bweq8527/GearPower/README.md

# GearPower

## 1.大致想法

灵感来自2024.09.02凌晨的一场梦，梦见一个超级炫酷的机甲，醒后依稀记得它的插入式电池仓，大致记录如下：
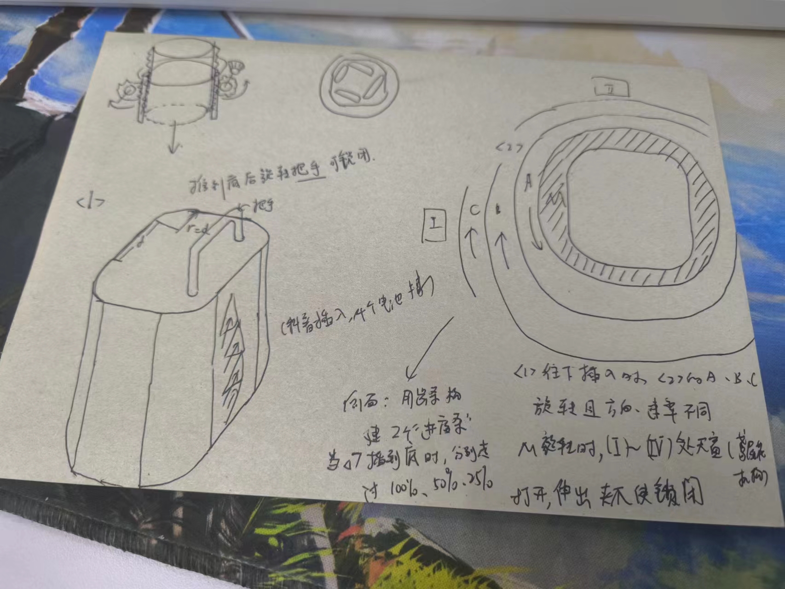
[picture p1: 0_Pics/0.jpg]


## 2.实现进度

①完成电池仓本体的设计及制造，效果如下：

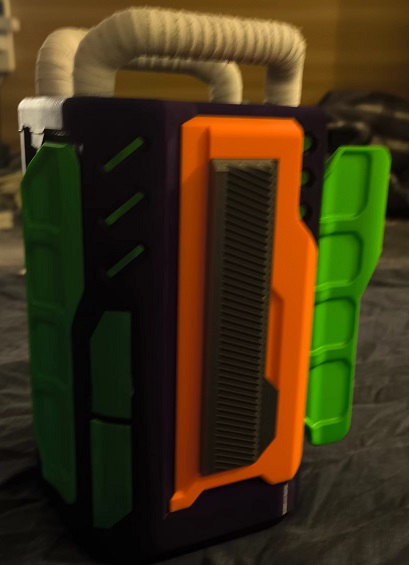
[picture p2: 0_Pics/1.jpg]


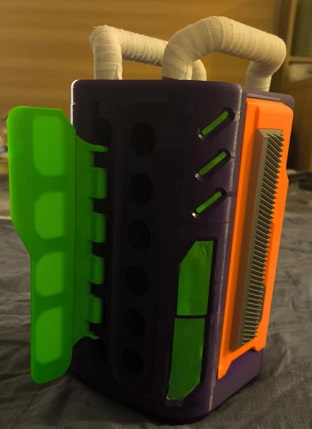
[picture p3: 0_Pics/2.jpg]


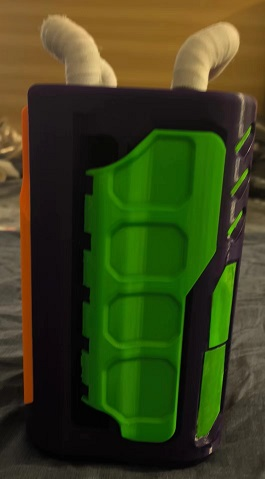
[picture p4: 0_Pics/3.jpg]


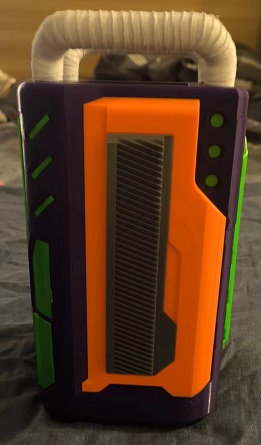
[picture p5: 0_Pics/4.jpg]


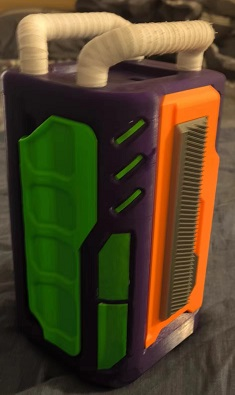
[picture p6: 0_Pics/5.jpg]


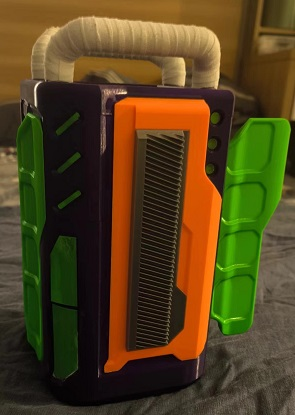
[picture p7: 0_Pics/6.jpg]


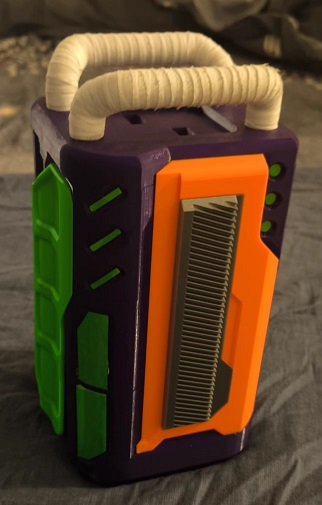
[picture p8: 0_Pics/7.jpg]
