bweq8527/GearPower/1_MechDesign/README.md

# BOM编制方式说明

#### 为方便查看各零件层级关系，辨别相似零件，采用如下编码原则：

1.A表示装配体，S表示零件

2.装配体结构层次序号按自顶向下递增的形式

3.ID为某零部件在项目中的唯一辨识序列号

#### 每个零部件的命名规则如下：

`A##`.`###`-`RK#`-`A/S` _ _ `[ID###]` _ _ `#####...`

> 第一段表示该零部件的父级是编号为##的子装配体

> 第二段表示该零部件在其所属的子装配体中的编号

> 第三段表示该零部件所属子装配体的层级

> 第四段表示该零部件类型，S为零件，A为装配体

> 第五段表示该零部件的唯一辨识序列号

> 第六段为零部件名称

注：上文命名规则中的空格作用为明确下划线个数，实际编码时，零件名称不存在空格

根据以上规则，当一个部件既是某个子装配体的顶层，又属于另一个装配体时，从两个不同的角度看，它会有不同的层级。因此生成两个同ID但不同编号的装配体来表示层级关系，如 `A02.000-RK4-S__[ID002]__BODY` 和 `A01.001.RK3-A__[ID002]__BODY` 是同一个装配体，由ID唯一确定。
