bweq8527/GearPower/1_MechDesign/A01.001-RK3-A__[ID012]__BODY.SLDASM

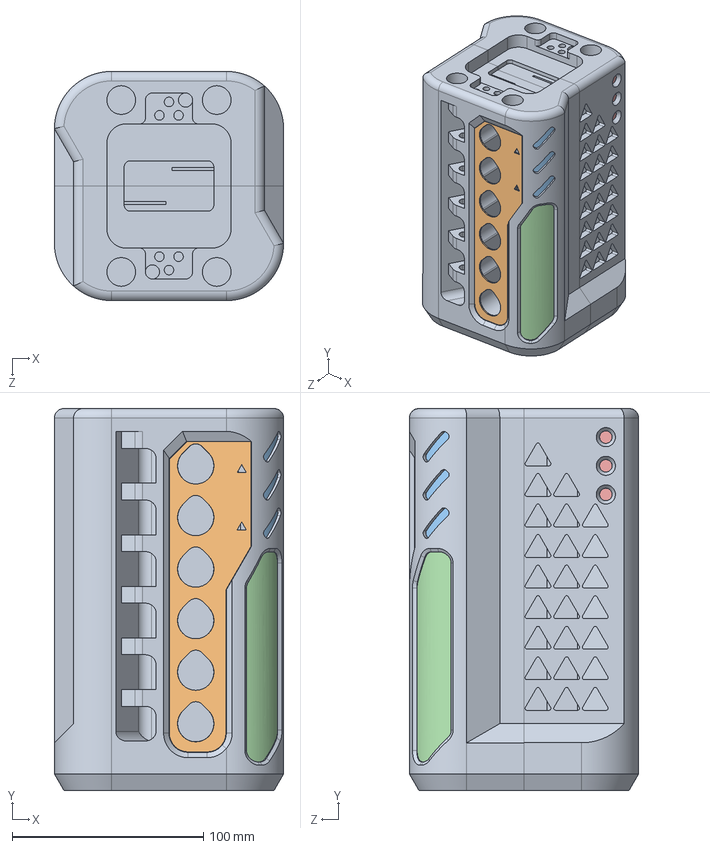
[picture p37: CAD file, 2024-11-07]
1_MechDesign/A01.001-RK3-A__[ID012]__BODY.SLDASM
120.0 x 200.0 x 120.0 mm
A02.001-RK4-S__[ID002]__Body
A02.002-RK4-S__[ID008]__Decoration1 x 2
A02.004-RK4-S__[ID010]__Decoration3 x 6
A02.003-RK4-S__[ID009]__Decoration2 x 2
A02.005-RK4-S__[ID011]__Decoration4 x 6
