bweq8527/GearPower/1_MechDesign/Locker.SLDASM

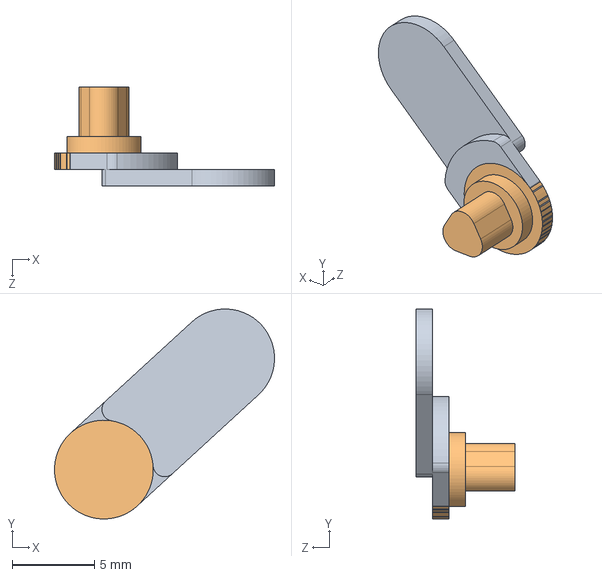
[picture p38: CAD file, 2024-11-07]
1_MechDesign/Locker.SLDASM
13.4 x 12.8 x 6.00 mm
Arm
Axis
