bweq8527/GearPower/1_MechDesign/A01.000-RK2-A__[ID001]__BatteryCompartment.SLDASM

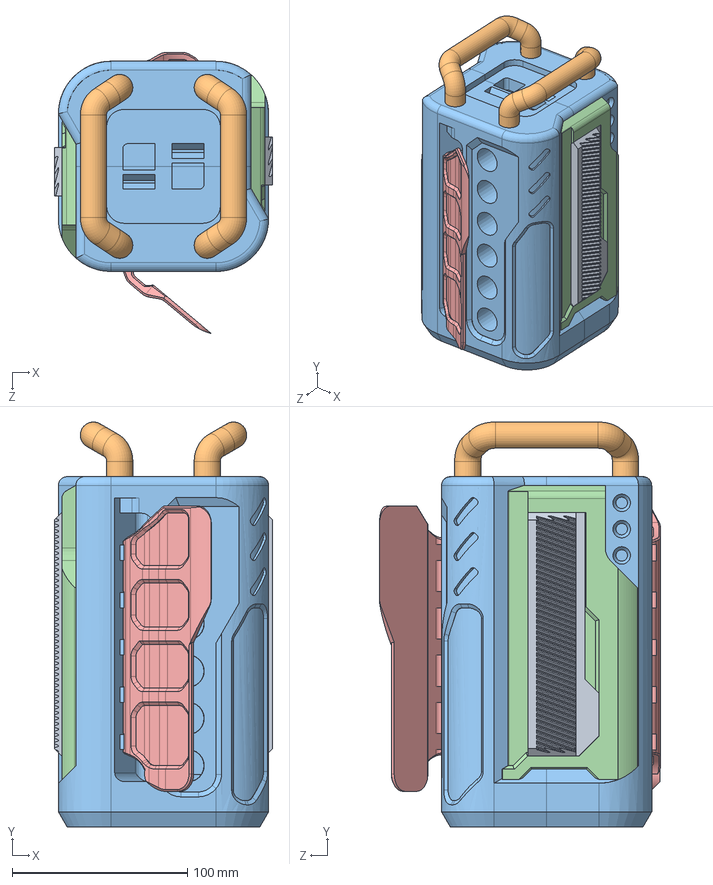
[picture p40: CAD file, 2024-10-26]
1_MechDesign/A01.000-RK2-A__[ID001]__BatteryCompartment.SLDASM
124.5 x 231.1 x 160.4 mm
A01.001-RK3-S__[ID002]__Body
A01.005-RK3-S__[ID006]__Handle x 2
A01.003-RK3-S__[ID004]__Connector1 x 2
A01.002-RK3-S__[ID003]__BatGov x 2
A01.004-RK3-S__[ID005]__GearRack1 x 2
