bweq8527/GearPower/2_Model/Body.STEP

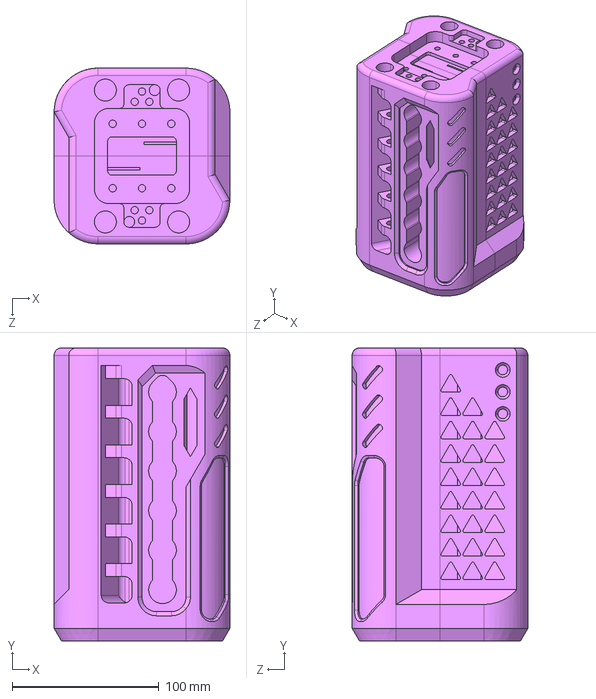
[picture p41: CAD file, 2024-11-07]
2_Model/Body.STEP
120.0 x 200.0 x 120.0 mm
