bweq8527/GearPower/2_Model/Model4-0.4.3mf

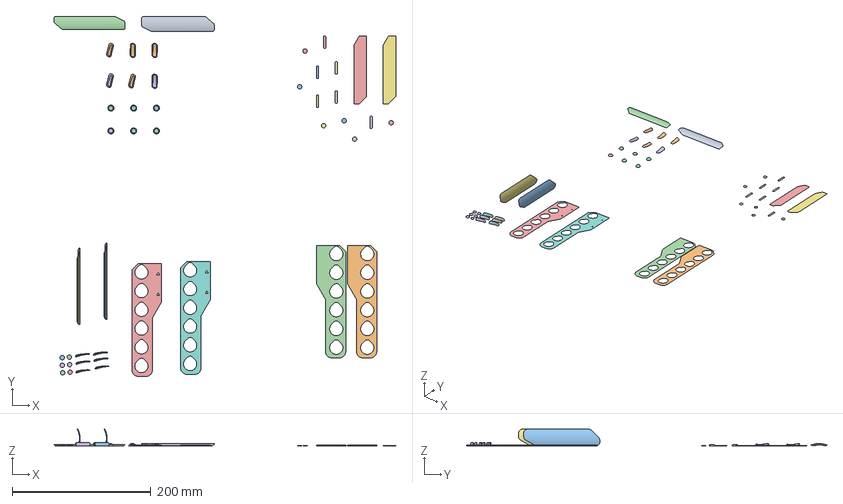
[picture p42: CAD file, 2024-11-07]
2_Model/Model4-0.4.3mf
492.5 x 519.1 x 24.1 mm
A01.001-RK3-S__[ID002.1]__Body-ex.STEP_8
Decoration1.STEP x 4
Decoration2.STEP x 2
Decoration3.STEP x 6
01245.STEP_1 x 3
A01.001-RK3-S__[ID002.1]__Body-ex.STEP_10
Decoration4.STEP x 6
01245.STEP_2
A01.001-RK3-S__[ID002.1]__Body-ex.STEP_20
01245.STEP_7
A01.001-RK3-S__[ID002.1]__Body-ex.STEP_11
01245.STEP_3
A01.001-RK3-S__[ID002.1]__Body-ex.STEP_9
01245.STEP_4 x 2
A01.001-RK3-S__[ID002.1]__Body-ex.STEP_12
01245.STEP_5
A01.001-RK3-S__[ID002.1]__Body-ex.STEP_21
01245.STEP_6 x 2
A01.001-RK3-S__[ID002.1]__Body-ex.STEP_14
01245.STEP_8
A01.001-RK3-S__[ID002.1]__Body-ex.STEP_22
A01.001-RK3-S__[ID002.1]__Body-ex.STEP_13
01245.STEP_10
A01.001-RK3-S__[ID002.1]__Body-ex.STEP_23
A01.001-RK3-S__[ID002.1]__Body-ex.STEP_15
01245.STEP_12
A01.001-RK3-S__[ID002.1]__Body-ex.STEP_24
A01.001-RK3-S__[ID002.1]__Body-ex.STEP_25
