bweq8527/GearPower/1_MechDesign/Arm.SLDPRT

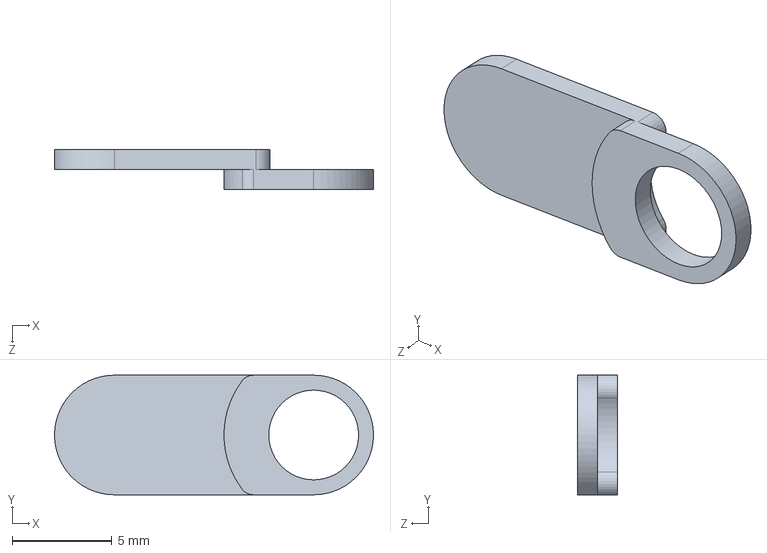
[picture p43: CAD file, 2024-11-07]
1_MechDesign/Arm.SLDPRT
16.0 x 6.00 x 2.00 mm
