bweq8527/GearPower/2_Model/Decoration1.STEP

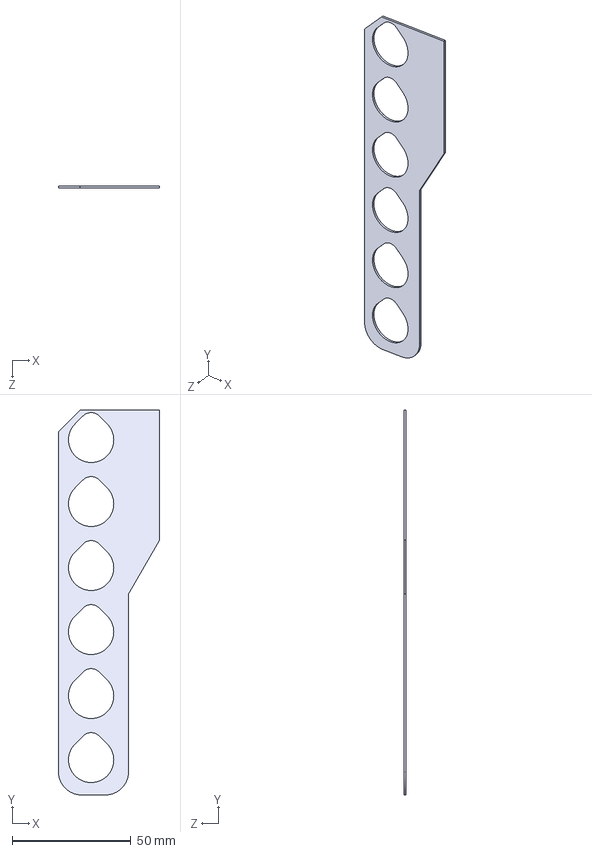
[picture p44: CAD file, 2024-11-07]
2_Model/Decoration1.STEP
42.7 x 162.4 x 1.00 mm
