bweq8527/GearPower/1_MechDesign/Axis.SLDPRT

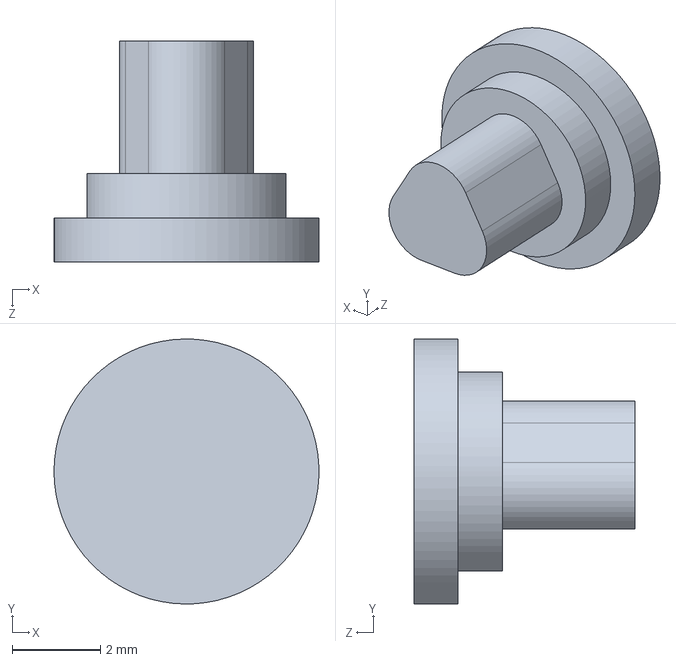
[picture p45: CAD file, 2024-11-07]
1_MechDesign/Axis.SLDPRT
6.00 x 6.00 x 5.00 mm
