bweq8527/GearPower/2_Model/Decoration2.STEP

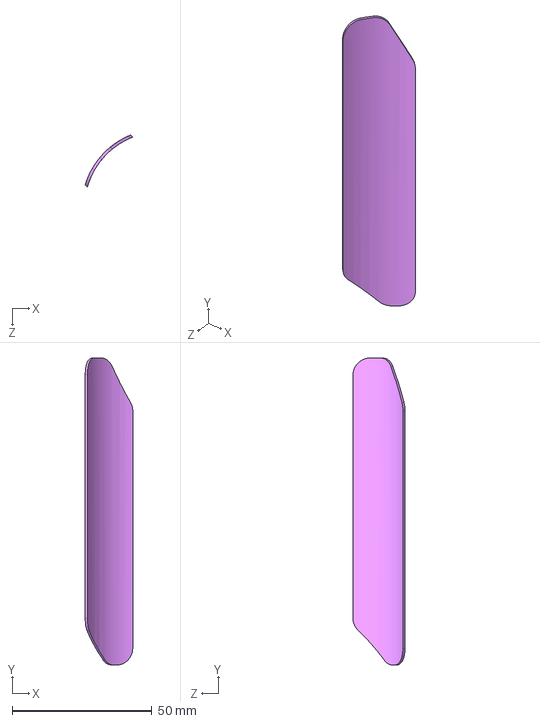
[picture p46: CAD file, 2024-11-07]
2_Model/Decoration2.STEP
17.1 x 110.0 x 18.6 mm
