bweq8527/GearPower/2_Model/Decoration3.STEP

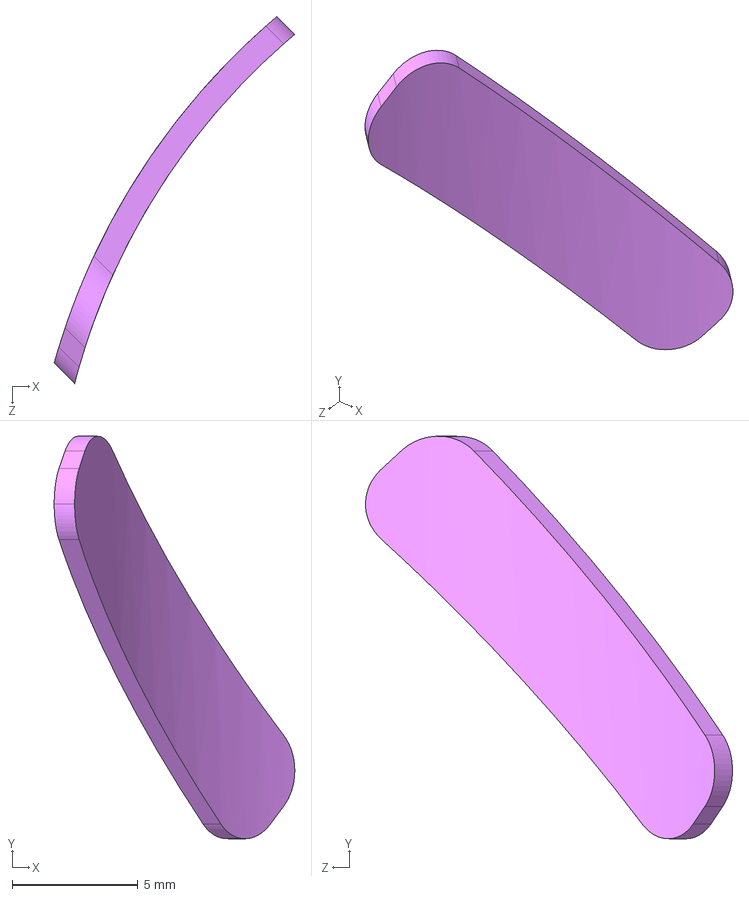
[picture p47: CAD file, 2024-11-07]
2_Model/Decoration3.STEP
9.58 x 16.0 x 14.6 mm
