bweq8527/GearPower/2_Model/Decoration4.STEP

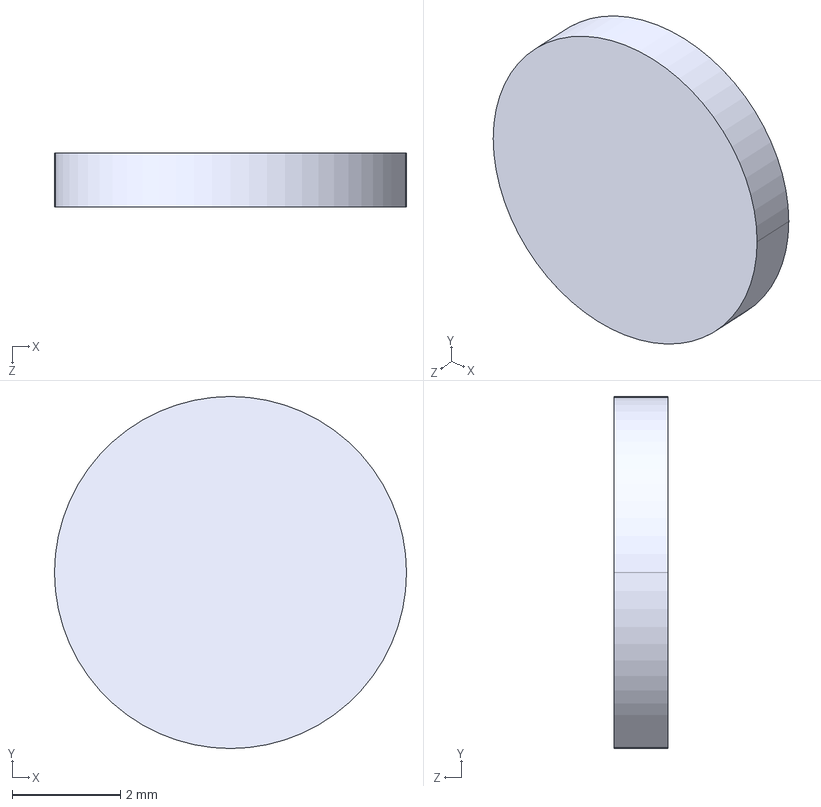
[picture p48: CAD file, 2024-11-07]
2_Model/Decoration4.STEP
6.50 x 6.50 x 1.00 mm
