bweq8527/GearPower/2_Model/Model2-0.4.3mf

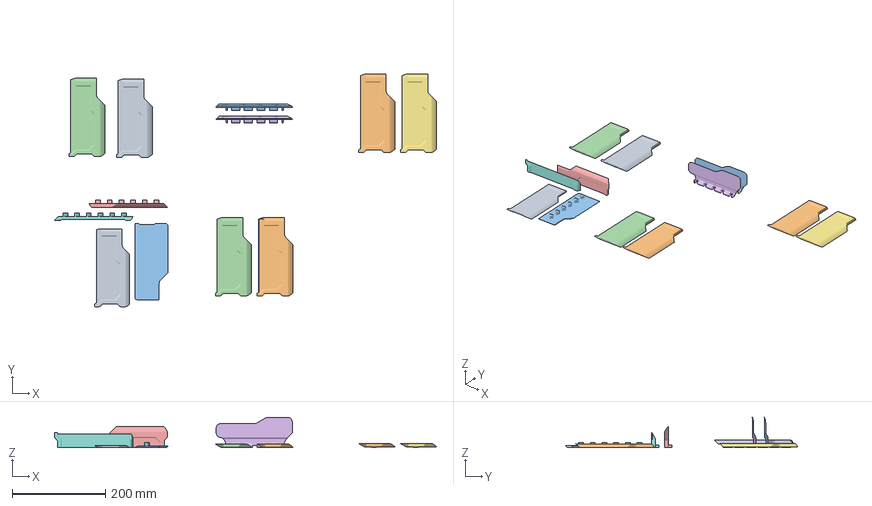
[picture p49: CAD file, 2024-10-31]
2_Model/Model2-0.4.3mf
817.9 x 498.0 x 64.8 mm
A01.003-RK3-S__[ID004]__Connector1.STEP x 4
A01.002-RK3-S__[ID003]__BatGov.STEP x 2
A01.003-RK3-S__[ID004]__Connector1.STEP_B x 2
A01.003-RK3-S__[ID004]__Connector1.STEP_A x 4
