bweq8527/GearPower/2_Model/Handle.STEP

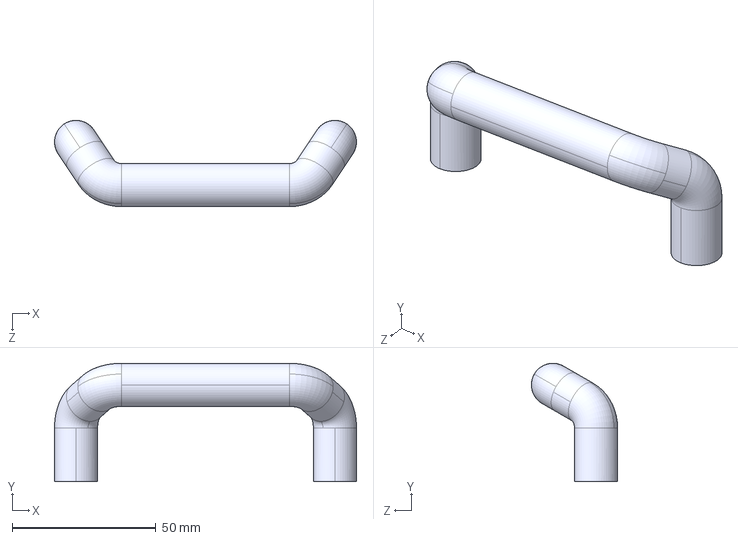
[picture p50: CAD file, 2024-10-29]
2_Model/Handle.STEP
105.0 x 41.2 x 30.0 mm
