bweq8527/GearPower/2_Model/BatGov.STEP

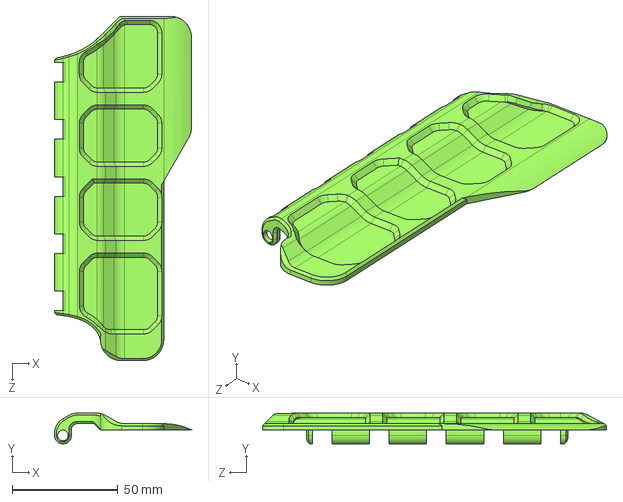
[picture p51: CAD file, 2024-10-29]
2_Model/BatGov.STEP
64.8 x 14.6 x 162.8 mm
