bweq8527/GearPower/2_Model/Model3-0.4.3mf

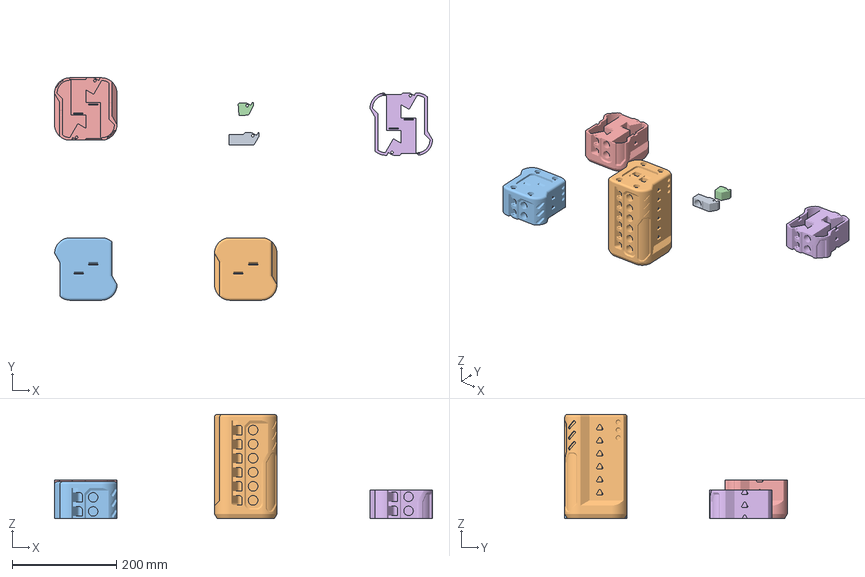
[picture p52: CAD file, 2024-10-29]
2_Model/Model3-0.4.3mf
725.7 x 427.2 x 200.0 mm
A01.001-RK3-S__[ID002]__Body.STEP_A_B_A_B_B_A
A01.001-RK3-S__[ID002]__Body.STEP
A01.001-RK3-S__[ID002]__Body.STEP_A_A
A01.001-RK3-S__[ID002]__Body.STEP_A_B_A_B_B_A_A
A01.001-RK3-S__[ID002]__Body.STEP_B_1
A01.001-RK3-S__[ID002]__Body.STEP_A_B_1
