bweq8527/GearPower/2_Model/GearRack1.STEP

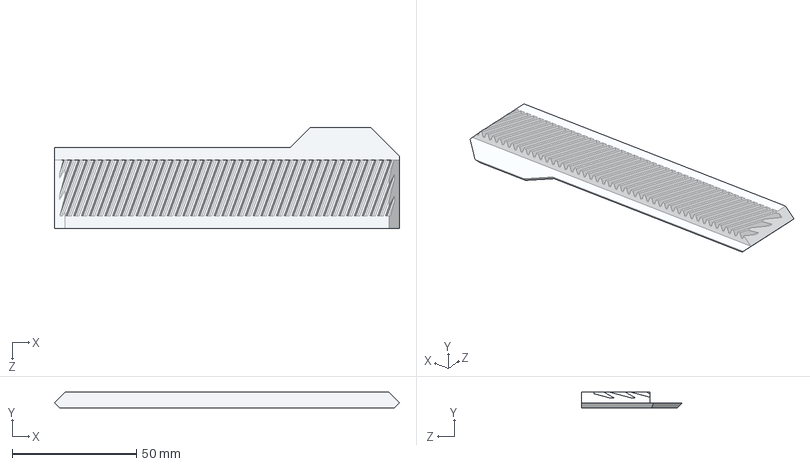
[picture p53: CAD file, 2024-10-29]
2_Model/GearRack1.STEP
139.0 x 6.25 x 40.5 mm
