bweq8527/GearPower/2_Model/Connector1.STEP

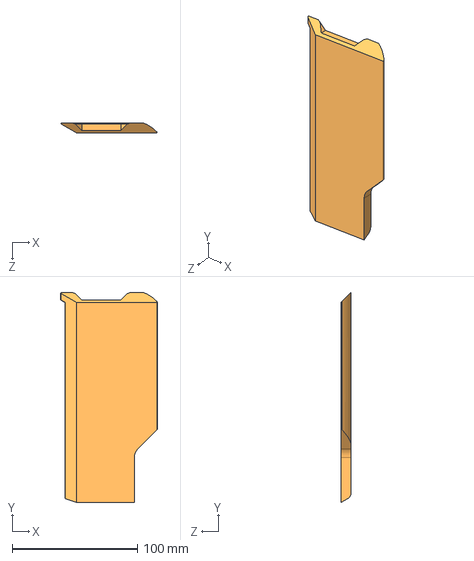
[picture p54: CAD file, 2024-10-29]
2_Model/Connector1.STEP
77.3 x 168.0 x 8.00 mm
