bweq8527/GearPower/2_Model/Model1-0.4.3mf

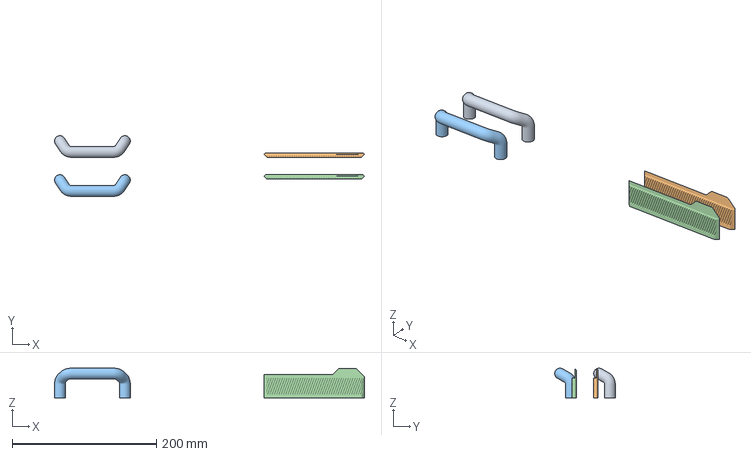
[picture p55: CAD file, 2024-09-11]
2_Model/Model1-0.4.3mf
429.2 x 84.0 x 41.2 mm
Handle.STL x 2
GearRack1.STL x 2
