bweq8527/GearPower/1_MechDesign/A03.001-RK3-S__[ID0013]__Gear1.SLDPRT

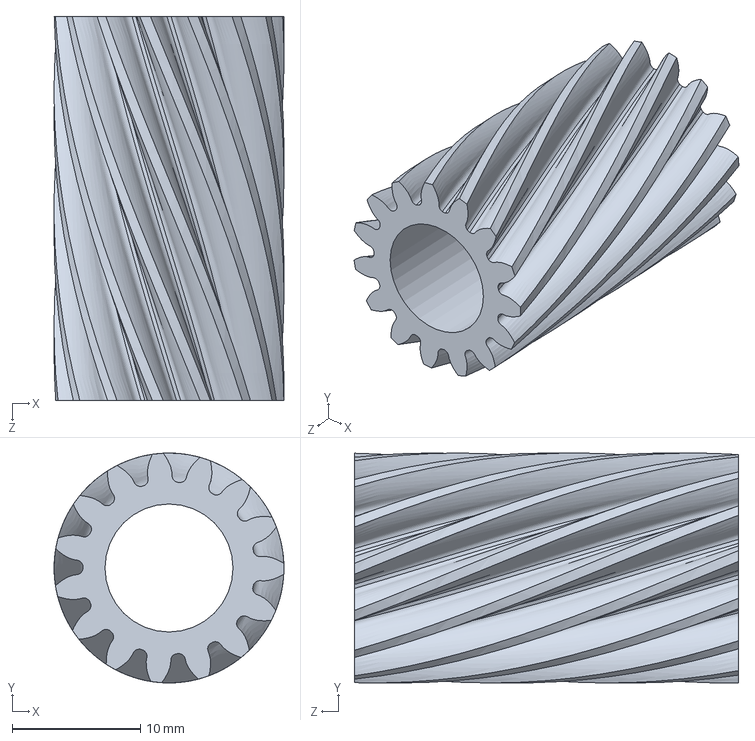
[picture p56: CAD file, 2024-09-11]
1_MechDesign/A03.001-RK3-S__[ID0013]__Gear1.SLDPRT
18.0 x 18.0 x 30.0 mm
