bweq8527/GearPower/1_MechDesign/A01.005-RK3-S__[ID006]__Handle.SLDPRT

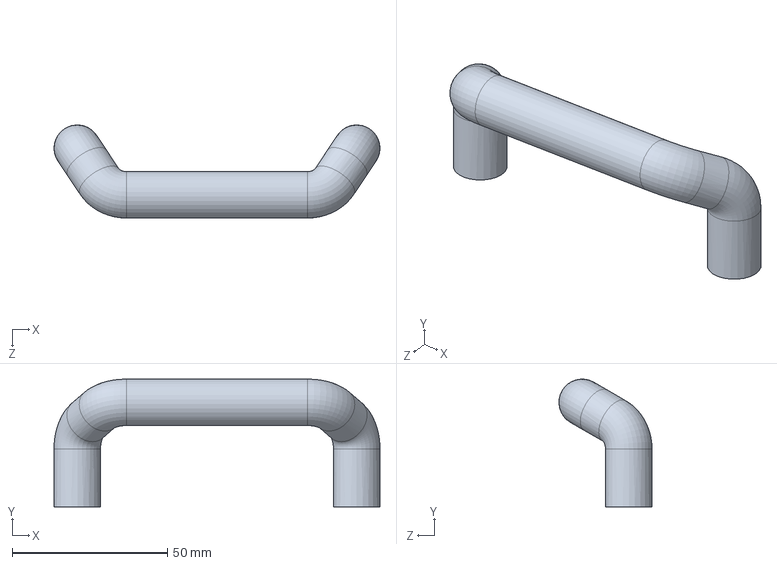
[picture p57: CAD file, 2024-09-05]
1_MechDesign/A01.005-RK3-S__[ID006]__Handle.SLDPRT
105.0 x 41.1 x 30.0 mm
