bweq8527/GearPower/(list of files, cad)

Other CAD files:
1_MechDesign/A00.000-RK1-A__[ID007]__GearPower.SLDASM
1_MechDesign/A02.002-RK4-S__[ID008]__Decoration1.SLDPRT
1_MechDesign/A02.004-RK4-S__[ID010]__Decoration3.SLDPRT
1_MechDesign/A02.003-RK4-S__[ID009]__Decoration2.SLDPRT
1_MechDesign/A02.005-RK4-S__[ID011]__Decoration4.SLDPRT
1_MechDesign/A01.001-RK3-S__[ID002]__Body.SLDPRT
1_MechDesign/A01.002-RK3-S__[ID003]__BatGov.SLDPRT
1_MechDesign/A01.003-RK3-S__[ID004]__Connector1.SLDPRT
1_MechDesign/A01.004-RK3-S__[ID005]__GearRack1.SLDPRT
