bweq8527/GearPower/(commit log)

2024-09-03 V0.99
    灵感
2024-09-03 V0.99.1.1
    完成电池仓本体及把手设计
    [BatteryCompartment.SLDPRT, BatteryCompartment.STL, GearPower.SLDASM, Handle.SLDPRT, Handle.STL]
2024-09-05 V0.99.1.2
    完成电池正极盖及齿条连接件的设计，并修改本体模型
    [BatGov.SLDPRT, BatGov.STL, BatteryCompartment.SLDPRT, BatteryCompartment.STL, Connector1.SLDPRT, Connector1.STL, GearPower.SLDASM, Handle.SLDPRT]
2024-09-06 V0.99.1.3
    完成齿条结构件的绘制，并为项目文件编写BOM规则、BOM编码
    [A00.000-RK0-A__[ID007]__GearPower.SLDASM, A01.000-RK1-A__[ID001]__BatteryCompartment.SLDASM, A01.001-RK2-S__[ID002]__Body.SLDPRT, A01.002-RK2-S__[ID003]__BatGov.SLDPRT, A01.003-RK2-S__[ID004]__Connector1.SLDPRT, A01.004-RK2-S__[ID005]__GearRack1.SLDPRT, A01.005-RK2-S__[ID006]__Handle.SLDPRT, A02.001-RK2-S__[ID007]__Gear1.SLDPRT]
2024-09-11 V0.99.1.4
    3D打印测试，发现以下问题：
    1.STL文件打印效果不好，更换用STEP格式
    2.用PLA和PETG相互支撑时，PLA可以沾到PETG表面上，但是PETG不容易粘在PLA表面
    [A00.000-RK1-A__[ID007]__GearPower.SLDASM, A01.000-RK1-A__[ID001]__BatteryCompartment.SLDASM, A01.000-RK2-A__[ID001]__BatteryCompartment.SLDASM, A01.001-RK2-S__[ID002]__Body.SLDPRT, A01.001-RK3-S__[ID002]__Body.SLDPRT, A01.001-RK3-S__[ID002]__Body.STEP, A01.002-RK2-S__[ID003]__BatGov.SLDPRT, A01.002-RK3-S__[ID003]__BatGov.SLDPRT]
2024-09-11 V0.99.1.5
    添加3D打印配置的描述文档
    [A01.000-RK2-A__[ID001]__BatteryCompartment.SLDASM, Model1-0.4.3mf, Model2-0.4.3mf]
2024-09-11 V0.99.1.6
    3D打印测试，发现如下问题：
    对于窄形打印件，分割打印时应该尽量横切（大面积作为截面），纵切（截面面积小）产生翘曲后基本无法进行粘合。
    [A01.000-RK2-A__[ID001]__BatteryCompartment.SLDASM]
2024-09-12 V0.99.1.7
    成功3D打印电池仓除本体外各配件
    [A01.002-RK3-S__[ID003]__BatGov.SLDPRT, A01.002-RK3-S__[ID003]__BatGov.STEP, Model2-0.4.3mf]
2024-09-14 V0.99.1.8
    成功打印电池仓所有部件并组装
    [Model3-0.4.3mf, Model4-0.4.3mf]
2024-10-26 V0.99.1.9a
    改进模型：
    1>电池孔直径过小，电池不能装入，扩大了孔径
    2>原模型不中心对称，对此做了调整
    3>装配时发现齿条架实际上不需要额外的定位桩，且要打印这些定位桩较困难，因此将其删去
    [A01.000-RK2-A__[ID001]__BatteryCompartment.SLDASM, A01.001-RK3-S__[ID002]__Body.SLDPRT, A01.002-RK3-S__[ID003]__BatGov.SLDPRT, A01.003-RK3-S__[ID004]__Connector1.SLDPRT, Model3-0.4.3mf]
2024-10-29 V0.99.1.9b
    根据模型的改进重新生成3D打印配置文件
    [A01.001-RK3-S__[ID002]__Body.STEP, A01.002-RK3-S__[ID003]__BatGov.STEP, A01.003-RK3-S__[ID004]__Connector1.STEP, A01.004-RK3-S__[ID005]__GearRack1.STEP, A01.005-RK3-S__[ID006]__Handle.STEP, Model2-0.4.3mf, Model3-0.4.3mf]
2024-10-31 V0.99.1.9c
    打印测试
    [Model2-0.4.3mf]
2024-11-02 V0.99.1.10a
    孔径实验1
2024-11-02 V0.99.1.10b
    孔径实验2
2024-11-02 V0.99.1.11a
    修改电池孔位的形状、尺寸
    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
    [A01.001-RK3-S__[ID002]__Body.SLDPRT]
2024-11-03 V0.99.1.11b
    1>新增舱盖轴安装孔位。
    2>调整了正、负极板的安装孔位。
    3>轴孔增大为一字孔；预留舱盖夹爪安装孔位
    4>分体式打印相关修改
    [A01.001-RK3-S__[ID002]__Body.STEP]
2024-11-07 V0.99.1.11c
    根据改进版的模型升级了装饰件
    [A01.001-RK3-A__[ID012]__BODY.SLDASM, A01.001-RK3-S__[ID002]__Body.STEP, A01.002-RK3-S__[ID003]__BatGov.STEP, A01.003-RK3-S__[ID004]__Connector1.STEP, A01.004-RK3-S__[ID005]__GearRack1.STEP, A01.005-RK3-S__[ID006]__Handle.STEP, A02.000-RK4-A__[ID012]__BODY.SLDASM, A02.001-RK3-S__[ID007]__Gear1.SLDPRT]
2024-11-07 V0.99.1.11d
    继续改良装饰件
    [A01.001-RK3-A__[ID012]__BODY.SLDASM, A02.002-RK4-S__[ID008]__Decoration1.SLDPRT, Decoration1.STEP, Model4-0.4.3mf]
2024-11-07 V0.99.1.11e
    新增：电池仓压杆
    [A01.001-RK3-A__[ID012]__BODY.SLDASM, A02.002-RK4-S__[ID008]__Decoration1.SLDPRT, Arm.SLDPRT, Axis.SLDPRT, Locker.SLDASM]
2024-11-07 V0.99.1.12a
    改进模型（详见说明文档）
    [A01.001-RK3-A__[ID012]__BODY.SLDASM, Body.STEP, Locker.SLDASM]
